romanetz/BalmerVNA/circuit/RF_INPUT_DIFF.brd

## EAGLE design circuit/RF_INPUT_DIFF.brd (2015-11-04)

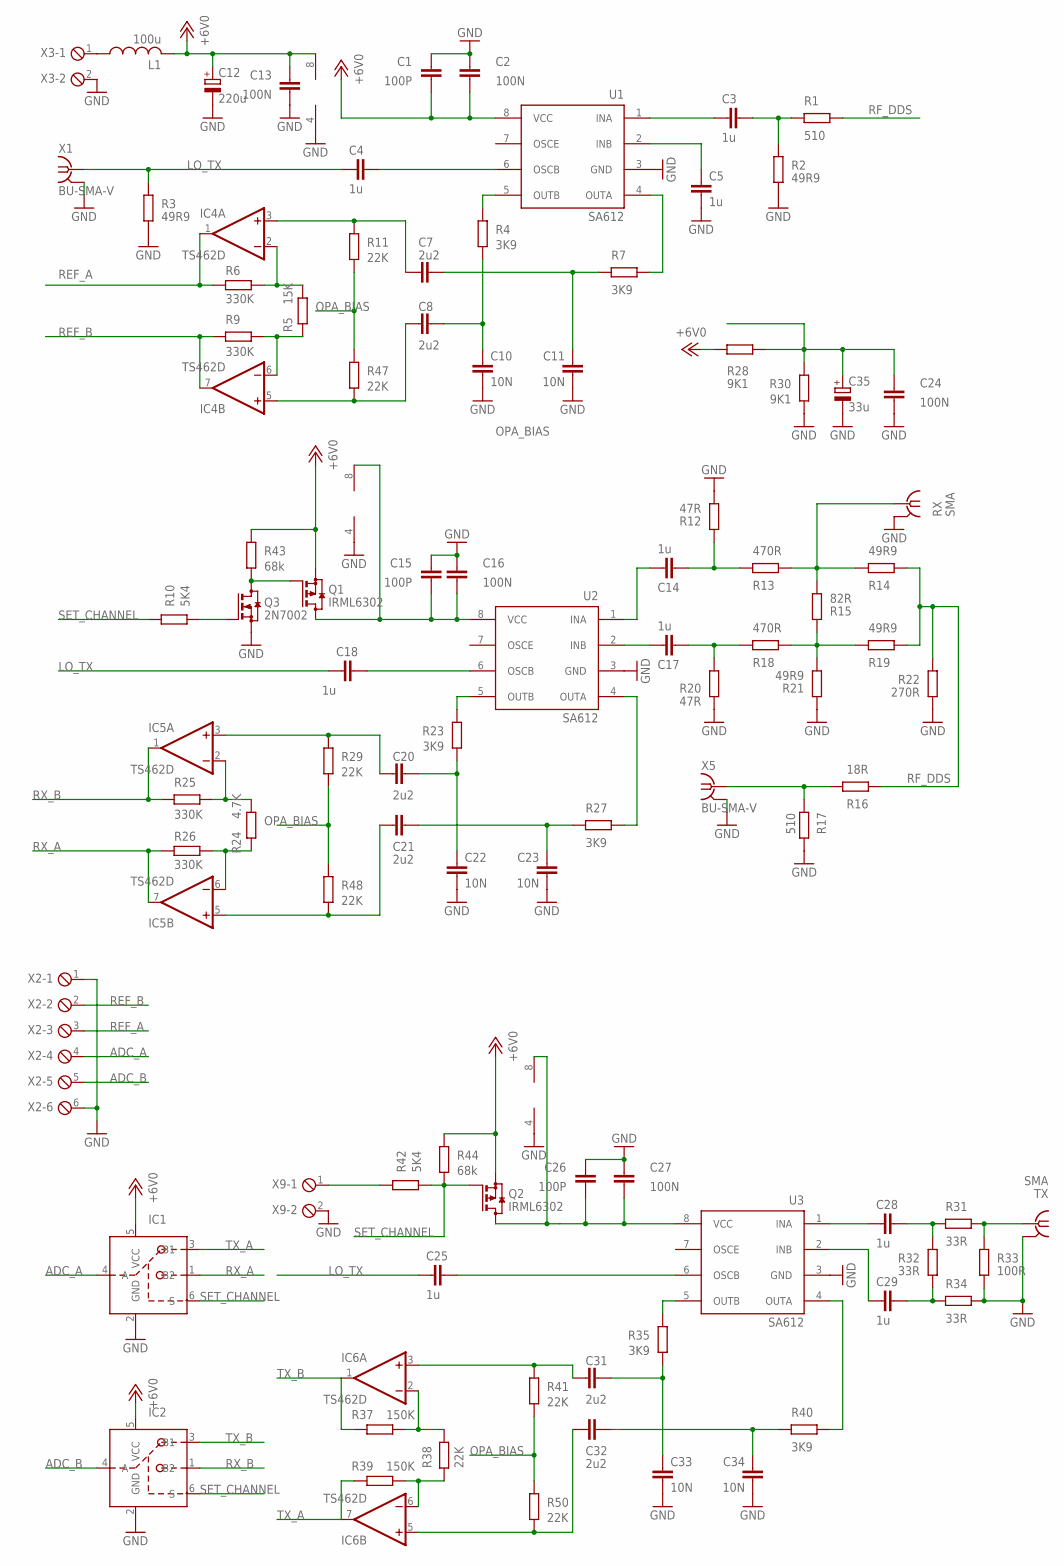
[picture p1: schematic RF_INPUT_DIFF.sch]

Parts:
C1, C15, C26: 100P; C0805
C2, C13, C16, C24, C27: 100N; C0603
C3, C5, C14, C17, C28, C29: 1u; C0603
C4, C18, C25: 1u; C0805
C7, C8, C20, C21, C31, C32: 2u2; C0805
C10, C11, C22, C23, C33, C34: 10N; C0805
C12: 220u; 153CLV-0605
C35: 33u; 153CLV-0605
IC1, IC2: SN74LVC1G3157DBVR; SOT23-6
IC4, IC5, IC6: TS462D; SO08
L1: 100u; 0207/12
Q1, Q2: IRML6302; SOT23
Q3: 2N7002; SOT23
R1, R17: 510; R0603
R2, R3, R14, R19, R21: 49R9; R0805
R4, R7, R23, R27, R35, R40: 3K9; R0603
R5: 15K; R0603
R6, R9, R25, R26: 330K; R0603
R10, R42: 5K4; R0603
R11, R29, R38, R41, R47, R48, R50: 22K; R0603
R12, R20: 47R; R0603
R13, R18: 470R; R0603
R15: 82R; R0603
R16: 18R; R0603
R22: 270R; R0603
R24: 4.7K; R0603
R28, R30: 9K1; R0603
R31, R32, R34: 33R; R0603
R33: 100R; R0603
R37, R39: 150K; R0603
R43, R44: 68k; R0603
RX: SMA; J502-ND-142-0701-801/806
TX: SMA; J502-ND-142-0701-801/806
U1, U2, U3: SA612; SO8
X1, X5: BU-SMA-V
X2: MPT6; 6POL254
X3, X9: MPT2; 2POL254

Connections:
+6V0: C1.1, C2.1, C12.+, C13.1, IC1.5 (VCC), IC2.5 (VCC), IC4.8 (V+), L1.2, Q1.2 (S), Q2.2 (S), R28.2, R43.1, R44.1, U1.8 (VCC)
ADC_A: IC1.4 (A), X2.4
ADC_B: IC2.4 (A), X2.5
GND: C1.2, C2.2, C5.2, C10.2, C11.2, C12.-, C13.2, C15.2, C16.2, C22.2, C23.2, C24.1, C26.2, C27.2, C33.2, C34.2, C35.-, IC1.2 (GND), IC2.2 (GND), IC4.4 (V-), IC5.4 (V-), IC6.4 (V-), Q3.2 (S), R2.1, R3.2, R12.2, R17.2, R20.1, R21.1, R22.2, R30.2, R33.2, R34.1, RX.G@1 (2), RX.G@2 (2), RX.G@3 (2), RX.G@4 (2), TX.G@1 (2), TX.G@2 (2), TX.G@3 (2), TX.G@4 (2), U1.3 (GND), U2.3 (GND), U3.3 (GND), X1.2, X1.3 (2), X1.4 (2), X1.5 (2), X2.1, X2.6, X3.2, X5.2, X5.3 (2), X5.4 (2), X5.5 (2), X9.2
LO_TX: C4.1, C18.1, C25.1, R3.1, X1.1
unnamed: R15.1, R18.1, R19.2, R21.2
unnamed: IC6.2 (-IN), R37.1, R38.1
unnamed: C25.2, U3.6 (OSCB)
unnamed: C26.1, C27.1, IC6.8 (V+), Q2.3 (D), U3.8 (VCC)
unnamed: R13.1, R14.2, R15.2, RX.1
unnamed: Q1.1 (G), Q3.3 (D), R43.2
unnamed: L1.1, X3.1
unnamed: C15.1, C16.1, IC5.8 (V+), Q1.3 (D), U2.8 (VCC)
unnamed: R42.1, X9.1
unnamed: IC4.2 (-IN), R5.1, R6.1
unnamed: C31.1, IC6.3 (+IN), R41.1
unnamed: C32.1, IC6.5 (+IN), R50.2
unnamed: IC4.6 (-IN), R5.2, R9.1
unnamed: Q3.1 (G), R10.2
unnamed: C7.1, IC4.3 (+IN), R11.1
unnamed: C8.1, IC4.5 (+IN), R47.2
unnamed: C20.1, IC5.3 (+IN), R29.1
unnamed: C21.1, IC5.5 (+IN), R48.2
unnamed: IC5.6 (-IN), R24.2, R26.1
unnamed: IC5.2 (-IN), R24.1, R25.1
unnamed: IC6.6 (-IN), R38.2, R39.1
unnamed: R31.1, R33.1, TX.1
unnamed: C28.2, R31.2, R32.1
unnamed: C29.2, R32.2, R34.2
unnamed: C29.1, U3.2 (INB)
unnamed: C28.1, U3.1 (INA)
unnamed: C31.2, C33.1, R35.2
unnamed: R40.1, U3.4 (OUTA)
unnamed: C32.2, C34.1, R40.2
unnamed: R35.1, U3.5 (OUTB)
unnamed: C17.1, U2.2 (INB)
unnamed: C17.2, R18.2, R20.2
unnamed: C14.1, U2.1 (INA)
unnamed: C20.2, C22.1, R23.2
unnamed: R27.1, U2.4 (OUTA)
unnamed: C21.2, C23.1, R27.2
unnamed: R23.1, U2.5 (OUTB)
unnamed: C14.2, R12.1, R13.2
unnamed: C18.2, U2.6 (OSCB)
unnamed: C5.1, U1.2 (INB)
unnamed: R14.1, R16.2, R19.1, R22.1
unnamed: C3.1, U1.1 (INA)
unnamed: C8.2, C10.1, R4.2
unnamed: R7.1, U1.4 (OUTA)
unnamed: C7.2, C11.1, R7.2
unnamed: R4.1, U1.5 (OUTB)
unnamed: C3.2, R1.2, R2.2
unnamed: C4.2, U1.6 (OSCB)
OPA_BIAS: C24.2, C35.+, R11.2, R28.1, R29.2, R30.1, R41.2, R47.1, R48.1, R50.1
REF_A: IC4.1 (OUT), R6.2, X2.3
REF_B: IC4.7 (OUT), R9.2, X2.2
RF_DDS: R1.1, R16.1, R17.1, X5.1
RX_A: IC1.1 (B2), IC5.7 (OUT), R26.2
RX_B: IC2.1 (B2), IC5.1 (OUT), R25.2
SET_CHANNEL: IC1.6 (S), IC2.6 (S), Q2.1 (G), R10.1, R42.2, R44.2
TX_A: IC1.3 (B1), IC6.7 (OUT), R39.2
TX_B: IC2.3 (B1), IC6.1 (OUT), R37.2

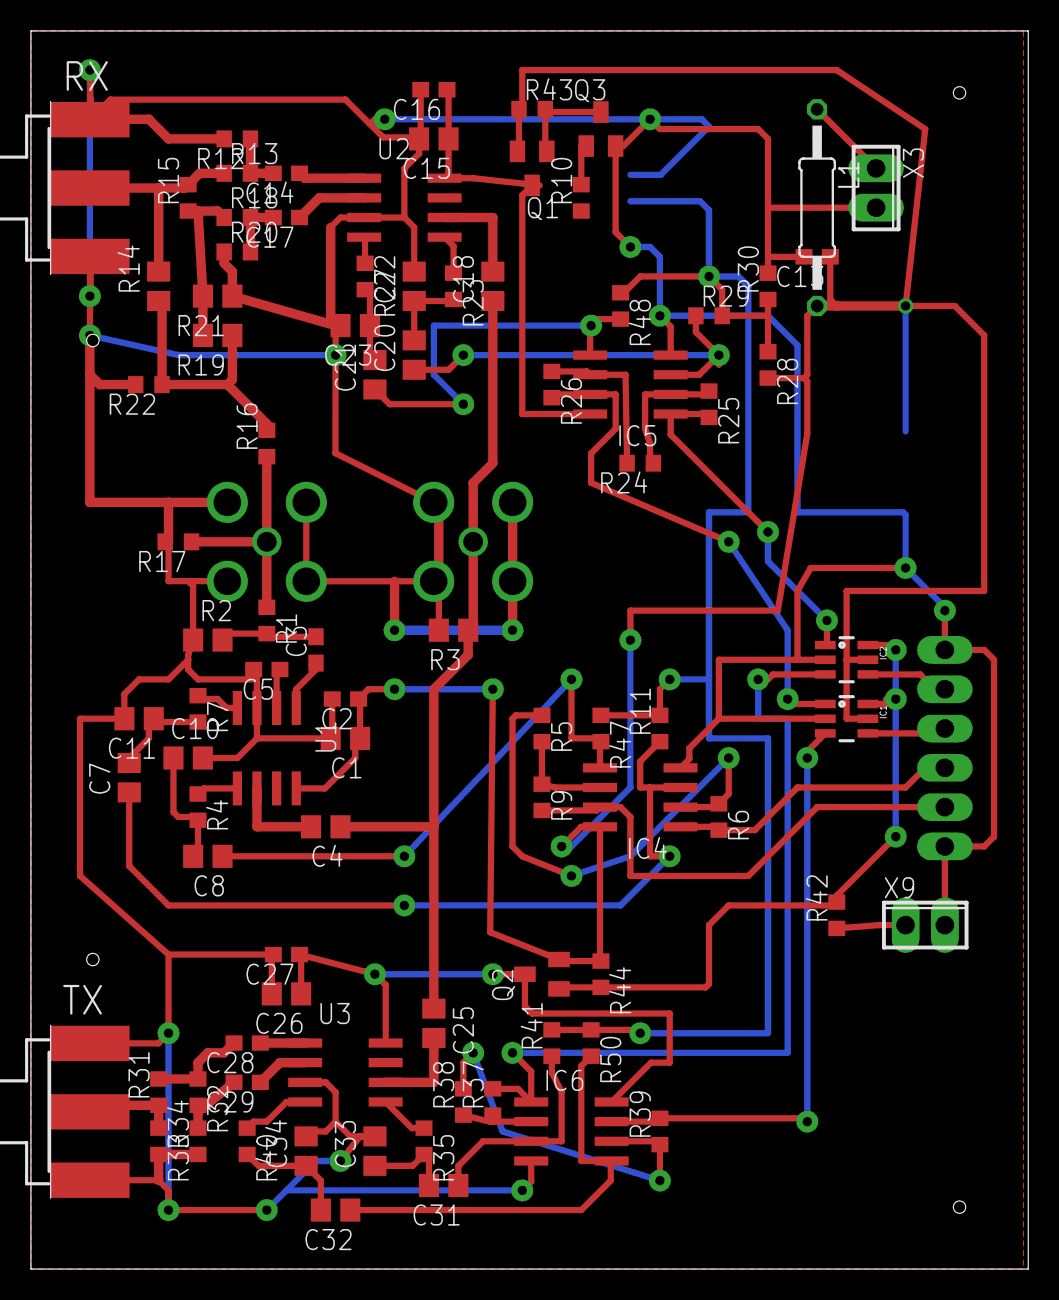
[picture p2: board RF_INPUT_DIFF.brd from above]

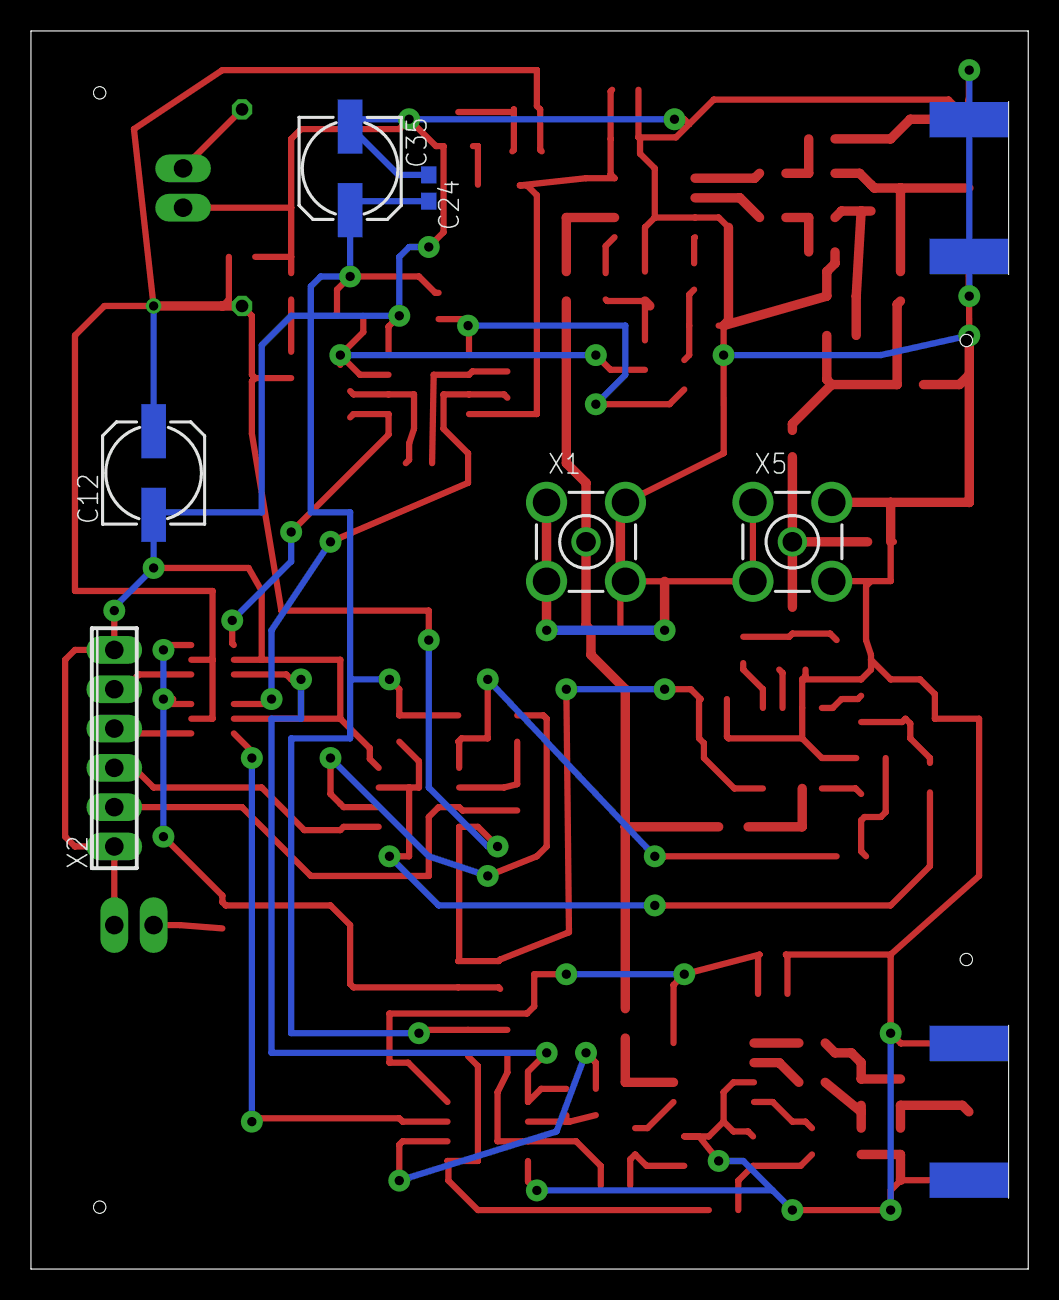
[picture p3: board RF_INPUT_DIFF.brd from below]

Board: 2 copper layers, 64.4 x 80.0 mm, 95 parts (6 on the bottom side), 62 nets.
