romanetz/BalmerVNA/circuit/ADC_DSP_DIFF.brd

## EAGLE design circuit/ADC_DSP_DIFF.brd (2015-10-11)

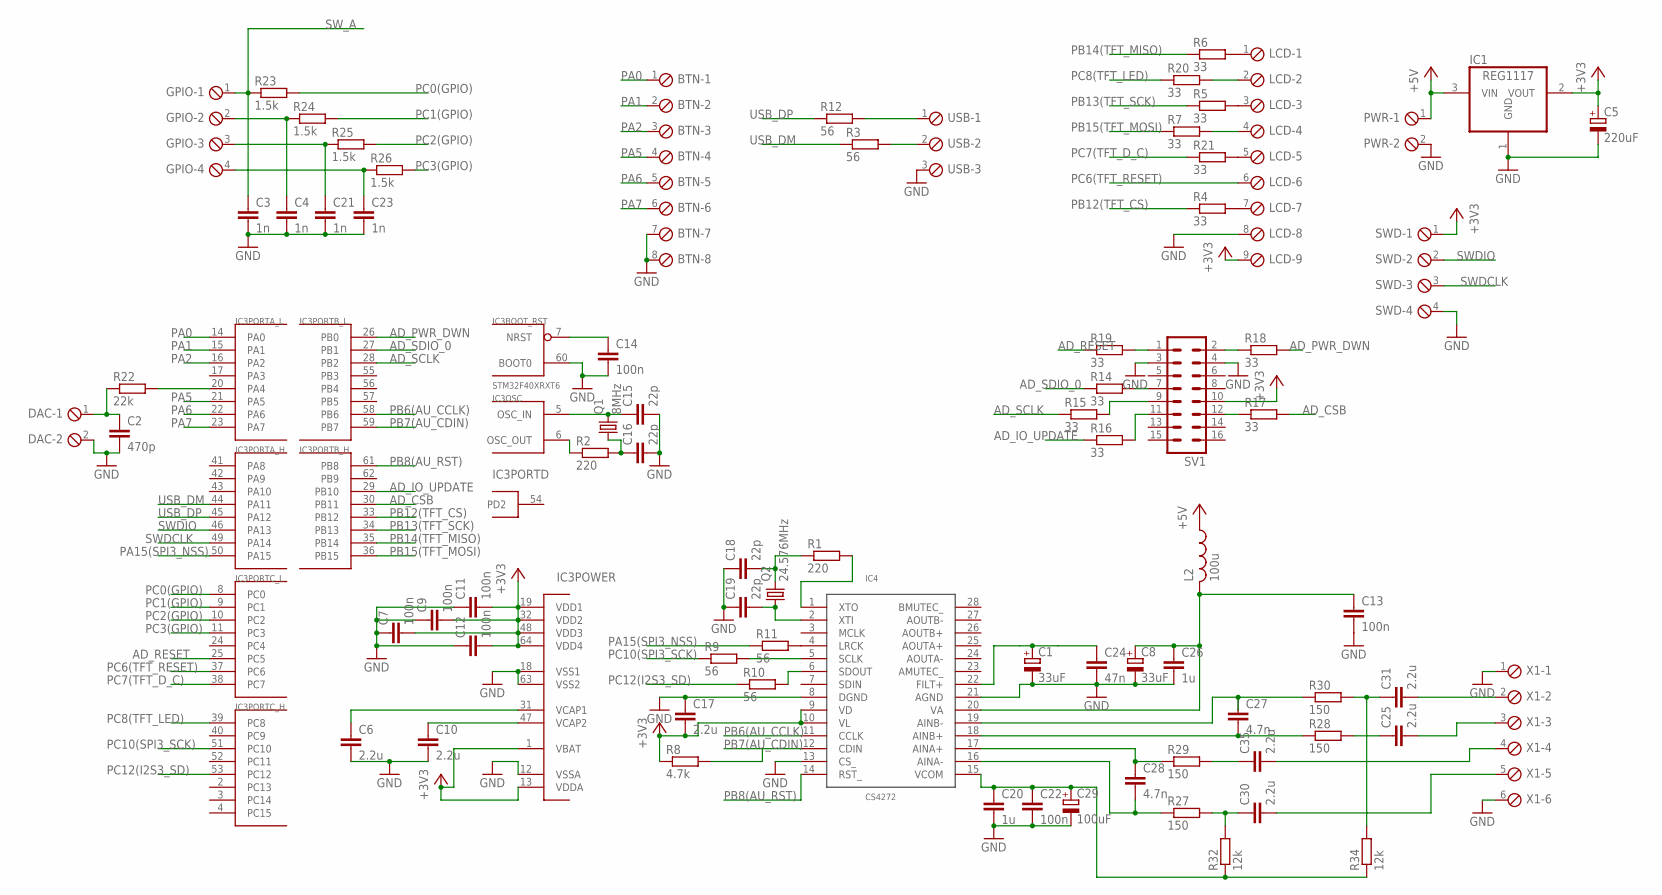
[picture p4: schematic ADC_DSP_DIFF.sch]

Parts:
BTN: MPT8; 8POL254
C1, C8: 33uF; 153CLV-0605
C2: 470p; C0805
C3, C4, C21, C23: 1n; C0805
C5: 220uF; 153CLV-0605
C6, C10, C17: 2.2u; C0603
C7, C9, C11, C12, C13, C14, C22: 100n; C0603
C15, C16, C18, C19: 22p; C0603
C20, C26: 1u; C0603
C24: 47n; C0805
C25, C30, C31, C35: 2.2u; C0805
C27, C28: 4.7n; C0805
C29: 100uF; 153CLV-0605
DAC: MPT2; 2POL254
GPIO: MPT4; 4POL254
IC1: REG1117; SOT223
IC3: STM32F40XRXT6; TQFP64
IC4: CS4272; TSSOP28
L2: 100u; 0207/12
LCD: MPT9; 9POL254
PWR: MPT2; 2POL254
Q1: 8MHz; HC49/S
Q2: 24.576MHz; HC49/S
R1, R2: 220; R0603
R3, R9, R10, R11, R12: 56; R0603
R4, R5, R6, R7, R14, R15, R16, R17, R18, R19, R20, R21: 33; R0603
R8: 4.7k; R0603
R22: 22k; R0603
R23, R24, R25, R26: 1.5k; R0603
R27, R28, R29, R30: 150; R0603
R32, R34: 12k; R0603
SV1: ML16
SWD: MPT4; 4POL254
USB: MPT3; 3POL254
X1: MPT6; 6POL254

Connections:
4052_B: C4.1, GPIO.2, R24.1
+3V3: C5.+, C7.2, C9.2, C11.2, C12.2, C17.2, IC1.2 (VOUT), IC3.1 (VBAT), IC3.13 (VDDA), IC3.19 (VDD1), IC3.32 (VDD2), IC3.48 (VDD3), IC3.64 (VDD4), IC4.9 (VD), IC4.10 (VL), LCD.9, R8.1, SV1.10, SWD.1
+5V: IC1.3 (VIN), L2.1, PWR.1
AD_CSB: IC3.30 (PB11), R17.2
AD_IO_UPDATE: IC3.29 (PB10), R16.1
AD_PWR_DWN: IC3.26 (PB0), R18.2
AD_RESET: IC3.25 (PC5), R19.1
AD_SCLK: IC3.28 (PB2), R15.1
AD_SDIO_0: IC3.27 (PB1), R14.1
AINB+: C27.2, IC4.18 (AINB+), R28.1
AVCC: C8.+, C13.1, C26.1, IC4.20 (VA), L2.2
D+: R12.2, USB.1
D-: R3.2, USB.2
GND: BTN.7, BTN.8, C1.-, C2.2, C3.2, C4.2, C5.-, C6.2, C7.1, C8.-, C9.1, C10.2, C11.1, C12.1, C13.2, C14.2, C15.2, C16.2, C17.1, C18.1, C19.1, C20.2, C21.2, C22.2, C23.2, C24.2, C26.2, C29.-, DAC.2, IC1.1 (GND), IC3.12 (VSSA), IC3.18 (VSS1), IC3.60 (BOOT0), IC3.63 (VSS2), IC4.8 (DGND), IC4.13 (CS_), IC4.21 (AGND), LCD.8, PWR.2, SV1.3, SV1.4, SWD.4, USB.3, X1.1, X1.6
unnamed: C10.1, IC3.47 (VCAP2)
unnamed: C6.1, IC3.31 (VCAP1)
unnamed: R16.2, SV1.11
unnamed: C14.1, IC3.7 (NRST)
unnamed: C15.1, IC3.5 (OSC_IN), Q1.2
unnamed: C16.1, Q1.1, R2.2
unnamed: C19.2, IC4.2 (XTI), Q2.1
unnamed: C18.2, Q2.2, R1.1
unnamed: IC4.4 (LRCK), R11.2
unnamed: IC4.5 (SCLK), R9.2
unnamed: IC4.6 (SDOUT), R10.2
unnamed: C1.+, C24.1, IC4.22 (FILT+)
unnamed: C27.1, IC4.19 (AINB-), R30.1
unnamed: R14.2, SV1.7
unnamed: C35.2, X1.4
unnamed: R19.2, SV1.1
unnamed: IC4.1 (XTO), R1.2
unnamed: C28.1, IC4.17 (AINA+), R29.1
unnamed: IC3.6 (OSC_OUT), R2.1
unnamed: LCD.1, R6.2
unnamed: LCD.3, R5.2
unnamed: LCD.2, R20.2
unnamed: R15.2, SV1.9
unnamed: LCD.4, R7.2
unnamed: C28.2, IC4.16 (AINA-), R27.1
unnamed: R18.1, SV1.2
unnamed: C31.1, R30.2, R34.2
unnamed: R17.1, SV1.12
unnamed: LCD.7, R4.2
unnamed: LCD.5, R21.2
unnamed: IC3.20 (PA4), R22.2
unnamed: C2.1, DAC.1, R22.1
unnamed: C30.1, R27.2, R32.2
unnamed: C25.1, R28.2
unnamed: C21.1, GPIO.3, R25.1
unnamed: C23.1, GPIO.4, R26.1
unnamed: C31.2, X1.2
unnamed: C35.1, R29.2
unnamed: C25.2, X1.3
unnamed: C30.2, X1.5
PA0: BTN.1, IC3.14 (PA0)
PA1: BTN.2, IC3.15 (PA1)
PA2: BTN.3, IC3.16 (PA2)
PA5: BTN.4, IC3.21 (PA5)
PA6: BTN.5, IC3.22 (PA6)
PA7: BTN.6, IC3.23 (PA7)
PA15(SPI3_NSS): IC3.50 (PA15), R11.1
PB6(AU_CCLK): IC3.58 (PB6), IC4.11 (CCLK)
PB7(AU_CDIN): IC3.59 (PB7), IC4.12 (CDIN), R8.2
PB8(AU_RST): IC3.61 (PB8), IC4.14 (RST_)
PB12(TFT_CS): IC3.33 (PB12), R4.1
PB13(TFT_SCK): IC3.34 (PB13), R5.1
PB14(TFT_MISO): IC3.35 (PB14), R6.1
PB15(TFT_MOSI): IC3.36 (PB15), R7.1
PC0(GPIO): IC3.8 (PC0), R23.2
PC1(GPIO): IC3.9 (PC1), R24.2
PC2(GPIO): IC3.10 (PC2), R25.2
PC3(GPIO): IC3.11 (PC3), R26.2
PC6(TFT_RESET): IC3.37 (PC6), LCD.6
PC7(TFT_D_C): IC3.38 (PC7), R21.1
PC8(TFT_LED): IC3.39 (PC8), R20.1
PC10(SPI3_SCK): IC3.51 (PC10), R9.1
PC12(I2S3_SD): IC3.53 (PC12), R10.1
SWDCLK: IC3.49 (PA14), SWD.3
SWDIO: IC3.46 (PA13), SWD.2
SW_A: C3.1, GPIO.1, R23.1
USB_DM: IC3.44 (PA11), R3.1
USB_DP: IC3.45 (PA12), R12.1
VCOM: C20.1, C22.1, C29.+, IC4.15 (VCOM), R32.1, R34.1

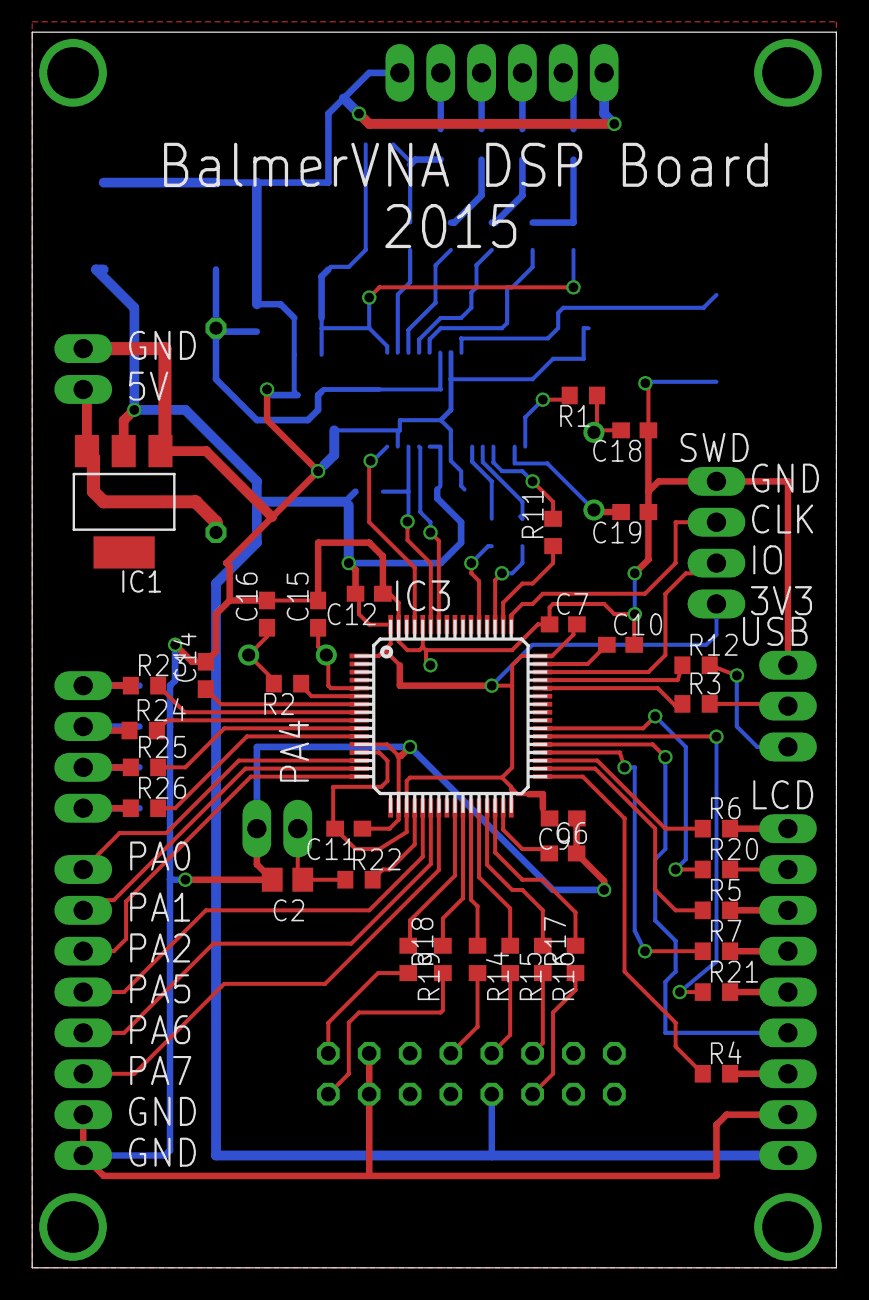
[picture p5: board ADC_DSP_DIFF.brd from above]

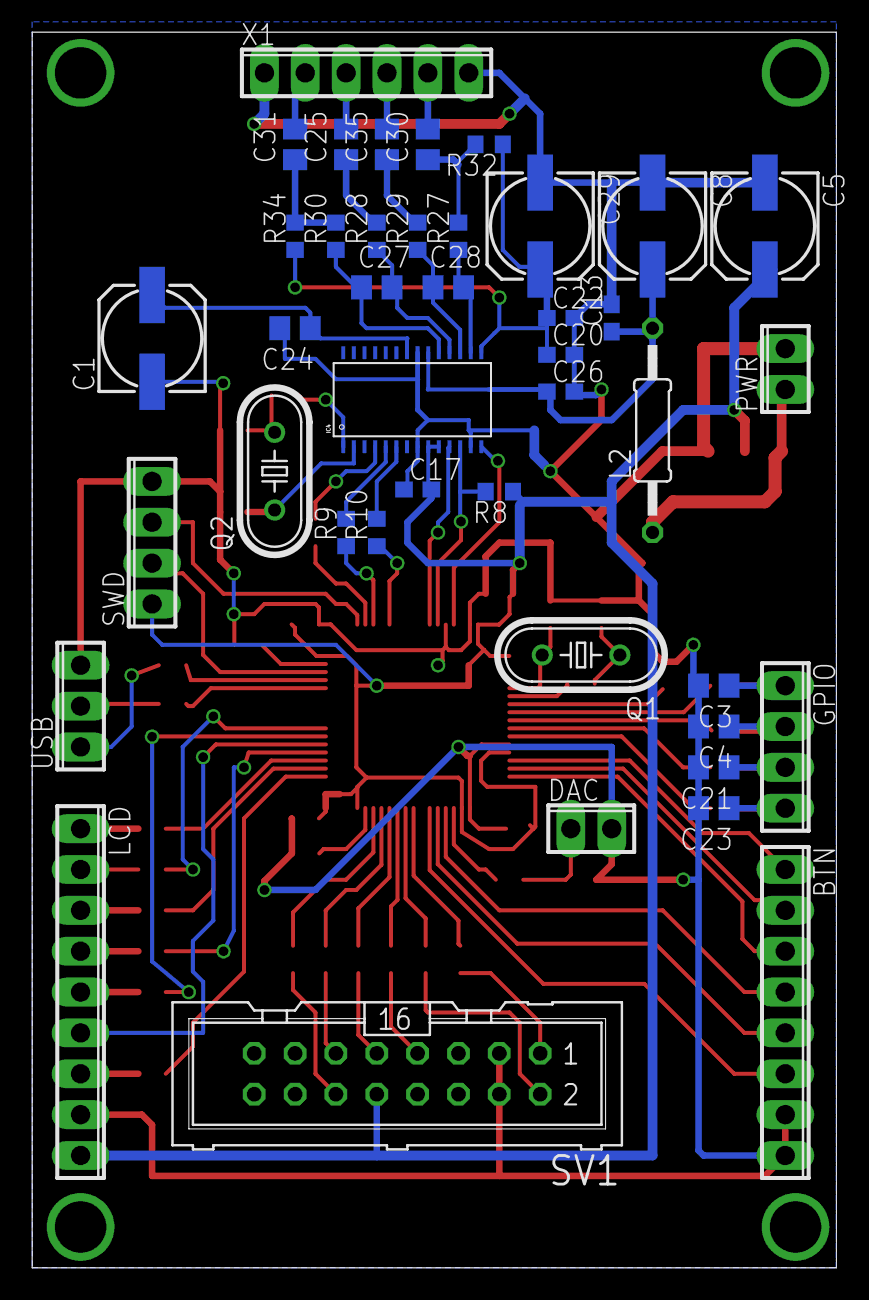
[picture p6: board ADC_DSP_DIFF.brd from below]

Board: 2 copper layers, 50.0 x 76.8 mm, 78 parts (42 on the bottom side), 83 nets.
