romanetz/BalmerVNA/4code/inc/main.h

//balmer@inbox.ru
//STM32F405+CS4272 DSP module
  
#ifndef _MAIN_H_
#define _MAIN_H_

//#include "stm32f4xx.h"
#include <stdio.h>
#include <stdbool.h>
#include "stm32f4xx_it.h"

void setTX(bool tx);
 
#endif//_MAIN_H_
