romanetz/BalmerVNA/(commit log)

2015-02-14 - пытается сделать DSP плату, в которой будут все необходимые выводы
    [ADC_DSP.brd, ADC_DSP.sch]
2015-02-15 - добавили LCD разъем
    [ADC_DSP.brd, ADC_DSP.sch]
2015-02-15 - добавил 4 GPIO
    [ADC_DSP.brd, ADC_DSP.sch]
2015-02-15 - развели еще немного
    [ADC_DSP.brd, ADC_DSP.sch]
2015-02-15 - развели в первом приближении
    [ADC_DSP.brd, ADC_DSP.sch]
2015-02-16 - развели вход для CS4272
    [ADC_DSP.brd, ADC_DSP.sch]
2015-02-18 - перед заменой на более быстрый мультиплексор.
    [ADC_DSP.brd, ADC_DSP.sch]
2015-02-18 - перержавел по халявному под SN74LVC1G3157DBVR
    [ADC_DSP.brd, ADC_DSP.sch]
2015-02-18 - более -менее разведенная плата
    [ADC_DSP.brd, ADC_DSP.sch]
2015-02-19 - уменьшили ширину платы
    [ADC_DSP.brd]
2015-02-21 - плата, которую будем травить
    [ADC_DSP.brd, ADC_DSP.sch]
2015-02-21 - один из проводов пересекался с другим
    [ADC_DSP.brd]
2015-02-24 - код выводящий данные на дисплей
2015-03-01 - работающий DDS
    [ADC_DSP.brd, ADC_DSP.sch]
2015-03-02 - довели до состояния "рабочая звуковая"
2015-03-07 - была ошибка в TimeMs() - конденсатор 100 uF на VCOM - не успевает выводить на дисплей и обрабатывать звук.
    [ADC_DSP.brd, ADC_DSP.sch]
2015-03-09 - начали делать высокочастотную входную часть
    [RF_INPUT.brd, RF_INPUT.sch]
2015-03-09 - развели половину
    [RF_INPUT.brd, RF_INPUT.sch]
2015-03-09 - почти разведенная схема
    [RF_INPUT.brd, RF_INPUT.sch]
2015-03-11 - добавили транзистор, чтобы переключалось одной линией. - индуктивность на питание
    [RF_INPUT.brd, RF_INPUT.sch]
2015-03-12 - немного компактифицировали
    [RF_INPUT.brd]
2015-03-13 - развели вчерновую
    [RF_INPUT.brd]
2015-03-13 - вроде готовая плата
    [RF_INPUT.brd]
2015-03-15 - то что напечатаем
    [RF_INPUT.brd]
2015-03-31 - работающий в первом приближении USB Virtual Com Port
    [ADC_DSP.brd, ADC_DSP.sch, RF_INPUT.brd, RF_INPUT.sch]
2015-04-03 - отсылаем/принимаем данные - скрипт для python3.4
2015-04-03 - посылаем и принимаем большие пачки данных
2015-04-05 - считываем синус с I/Q канала
2015-04-05 - графики похожие на правду!
2015-04-06 - переключение RX/TX
2015-04-07 - определяем частоту сигнала
2015-04-08 - убрали ошибку связанную с округлением, при установке частоты. Теперь ПЧmax - ПЧmin = 0.3 Hz (а раньше было 0.5 Hz)
2015-04-09 - вычисляем фазу и выводим на экран
2015-04-10 - метод Гауда для нашей системы уравнений - подредактировали ADC_DSP чтобы на одну страницу влезало
    [ADC_DSP.sch]
2015-04-12 - иногда на 1, а иногда на 2 байта ошибается при чтении из CS4272
    [RF_INPUT.sch]
2015-04-12 - говнокод, запускаем SPI/DMA раньше, чем CS4272. Для того, чтобы одинаковые данные приходили постоянно.
2015-04-12 sin -> sinf . Теперь код работает за разумное время
2015-04-13 - добавили пример AD9958 платки
    [dds_ad9958.brd, dds_ad9958.sch]
2015-04-14 - быстрое сканирование диапазона, с расчетами на микроконтроллер
2015-05-16 - немного математики
2015-09-20 - начали рисовать платку с дифференциальным входом.
    [ADC_DSP_DIFF.brd, ADC_DSP_DIFF.sch, RF_INPUT.brd, RF_INPUT.sch]
2015-09-21 - немного развели схему.
    [ADC_DSP_DIFF.brd]
2015-09-24 - скомпилировали под Linux
    [ADC_DSP_DIFF.brd]
2015-09-24 - проект для Qt Creator для удобного редактирования исходников.
2015-09-27 - отделили команды от девайса
    - добавили тулбар
    - проверили encode/decode на "big data"
2015-09-30 - немного работы с COM port
    - подключили QCustomPlot
2015-10-01 - вроде все линии переразвели
    [ADC_DSP_DIFF.brd, ADC_DSP_DIFF.sch]
2015-10-03 - class VnaCommand, команды, которые можно добавлять в очередь.
    [ADC_DSP_DIFF.brd]
2015-10-03 - последовательность команд, выполняемая асинхронно.
2015-10-03 - добавили VnaSamplingBufferSize
    - добавили возможность перезапустить команду
2015-10-03 - прочитали данные и запихнули на график.
2015-10-05 - добавили ring_buffer
    - добавили много команд
    - определили, что из-за того, что девайс определяется как ttyACMx ему посылаются AT команды
2015-10-06 - после того, как считали данные с девайса, показываем график.
2015-10-08 - запустили команды COMMAND_GET_CALCULATED и COMMAND_START_SAMPLING_AND_CALCULATE
2015-10-09 - график успешно нарисовался по данным просчитанным железкой.
2015-10-11 - версия, которую будем отправлять на завод
    [ADC_DSP_DIFF.brd]
2015-10-18 - пршем данные в xml
2015-10-18 - пишем данные в xml
2015-10-18 - читаем данные в python
2015-10-23 - немного расчетов
2015-10-23 - непонятная R1=50 всегда
2015-10-23 - все загадочнее и загадочнее, проверили все :)
2015-10-23 - нашли, где плюсик с минусиком был перепутан
2015-10-23 - несколько часов мучений, и графики vcc1 совпадают!
2015-10-24 - стандартные частоты для калибровки
2015-10-26 - open-short-load калибровка по Z
    [graph_u2.py, mainwindow.cpp, xml_plot.py]
2015-10-28 - забытый calibration.py
2015-10-29 - мысли про tx канал
2015-10-29 - добавили калибровочные данные в хранилище
2015-10-30 - немного gitignore
2015-10-30 - удалили из репозиртория пользовательский файл.
2015-10-31 - начали делать вариант с дифференциальным выходом.
    [RF_INPUT_DIFF.brd, RF_INPUT_DIFF.sch]
2015-10-31 - продолжили работу над diff входом
    [RF_INPUT_DIFF.brd, RF_INPUT_DIFF.sch]
2015-11-01 - начали рисовать платку для diff выхода.
    [RF_INPUT_DIFF.brd, RF_INPUT_DIFF.sch]
2015-11-02 - просто, чтобы совпададало с домашней версией.
2015-11-03 - TX выдает разумные данные!
2015-11-03 - последние изменения, просто для синхронизации
2015-11-04 - еще немного развели плату
    [RF_INPUT_DIFF.brd]
2015-11-04 - начали калибровку по S параметрам
    [RF_INPUT_DIFF.brd, RF_INPUT_DIFF.sch]
2015-11-05 - работающая calculateS11_S21 для случая подключения симметричного элемента между RX и TX
2015-11-08 - начали делать диалог выбора частоты.
2015-11-08 - диалог DialogSelectFrequency
